pepper0707/Tangible-Games/README.md

# Tangible Games Assessment - Record Revolution
- Development Portfolio - Documentation of development process
- RecordRevolution – Main Game Code
- Sounds – Audio used in our game, and required library
