pepper0707/Tangible-Games/Development Portfolio/05 - User documentation/README.md

# User documentation and health and safety warnings.

## An outline of how to play our game 

- The player must first press the red button at the bottom left of the board to start.

- You will then have the option to choose between two difficulties (One with special LEDS and one without). You do this by moving the marker to either the left or right side and the pressing the button to confirm. After a 3 second countdown will start

- You must spin the record such that the marker passes a LED in the correct direction. Cyan lights must be passed clockwise and Pink lights must be passed anti-clockwise. If you chose difficulty 2 you may have Green lights. For these all you must do is spin past them twice without changing your direction.

- The game lasts for 60 seconds if you rack up enough points to beat the high score you will be prompted to enter your name. So that your score can be recorded for other players too see.

- You can now repeat to play again.

We created a basic rules poster for players to quickly reference if they get confused on colours mid game:
Rules

## Health and saftey warnings
- There are some exposed electronics that players clothing could get caught on. So it might be advisable to roll up your sleeves if applicable.
- The record is attached to with nuts and bolts that are exposed on top of the record. If spinning the record overly aggressively these could run into the players hand or fingers.
- The push button is rather crudely constructed and has some sharp edges. We did  attempt to cover them with blue tac but its not a foolproof fix and a player could potentially harm themselves if they missed the button and pressed very firmly on the blue tac area.

## Statement of attribution
- Chloe: Created Rules Poster
