pepper0707/Tangible-Games/(commit log)

2025-05-18 sound, displays and button
2025-05-19 accounted for led strip counting clockwise, and now remove used pixels by shifting array
2025-05-19 button start
2025-05-19 led test
2025-05-20 reset high score on button hold
2025-05-21 current letter now blinks
2025-05-21 you need to collect a led before collecting one you have alrady passed over
2025-05-21 added deadzone so leds dont spawn near the marker
2025-05-22 reduced name arrays and added more resets to led off
2025-05-23 tried to fix issues around the start and end of strip
    [RecordRevolution.ino]
2025-05-23 new leds dont spawn in a deadzone around existing leds
2025-05-23 orginsation, name buffer fixes, score clamping
    [RecordRevolution.ino]
2025-05-26 Create Magnetic Encoder Diagram.png
